Adog64/ECE-Synthesizer-Spring-2023/README.md

# ECE-Synthesizer-Spring-2023

Our project consists of a synthesizer that plays notes from C4 to B5 using buttons. The MSP430 provides square, triangle, and sawtooth waves. The audio will be comprised of a combination of these waves, which can be altered. The volume will be adjustable.
