Adog64/ECE-Synthesizer-Spring-2023/MSP-EXP430FR2355_Hardware_Design_Files/Readme.txt

MSP-EXP430FR2355 Hardware Design Files v1.00.00
Texas Instruments, Inc.

********************************************************************************
Welcome to the MSP-EXP430FR2355 LaunchPad!
********************************************************************************

In this package, you will find hardware design files that can help you quickly
get started on developing your own project.

Available in the 'Hardware' folder are the complete board schematic and layout,
bill of material and Gerber files. This board was designed using Altium.

You can also find various web links in the 'Documentation' folder pointing to
the Tool Page, Quick Start Guide, and User's Guide.

For more resources, be sure to visit www.ti.com/tool/msp-exp430fr2355

********************************************************************************
Revision History
********************************************************************************
Ver 1.00.00 - May 15, 2018
- Initial Release of Rev1.0 PCB

********************************************************************************
Project File Listing
********************************************************************************
|--Documentation                      : Folder containing links to more resources
|--Hardware                           : Folder containing hardware design files,
                                        bill of material and gerber files
|--Readme.txt                         : This file
