Adog64/ECE-Synthesizer-Spring-2023/Write Ups/ProjectOverview.tex

\documentclass{IEEEtran}

\title{Homebrew Synthesizer}
\author{Aidan Sharpe \& Elise Heim}

\begin{document}
\maketitle

\begin{abstract}
    This homebrew synthesizer combines the worlds of embedded systems and electronics. Using an array of buttons as inputs, a monophonic---one note at a time--- output frequency can be selected. All fundamental waveforms, whether that be square, triangle, saw tooth, or sine, are generated simultaneously and at the same frequency by the onboard microcontroller. Fundamental waveforms are outputted on separate channels, so each can be treated as a component of a final mixed waveform. Using a digital to analog converter, each output can be scaled using a rheostat. Using a voltage summer, the fundamental waveforms are combined to create a unique sound which can be output over an onboard headphone jack or a Bluetooth signal.
\end{abstract}

\section{Block Diagraming}

\end{document}
