Adog64/ECE-Synthesizer-Spring-2023/MSP430FR2355-Package-Outline.png

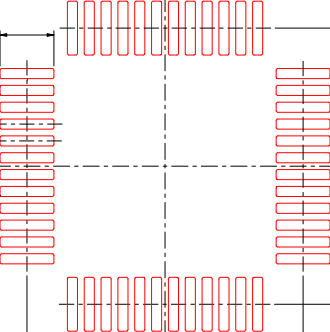
MSP430FR2355-Package-Outline.png
