Adog64/ECE-Synthesizer-Spring-2023/NINA-W156-Mechanical.png

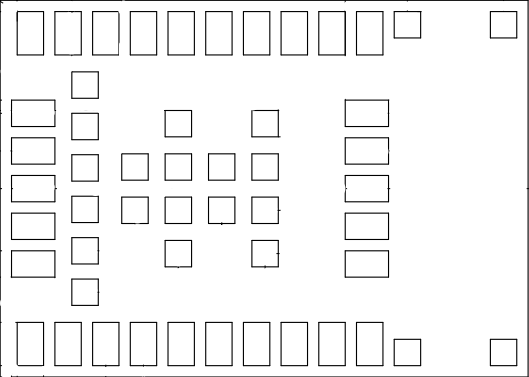
NINA-W156-Mechanical.png
