Adog64/ECE-Synthesizer-Spring-2023/MSP-EXP430FR2355_Hardware_Design_Files/Hardware/MCU036A(001)_BOM.xls

Filename: | #VALUE!
Variant: | 001
Generated: | 3/2/2018 10:15:17 AM
 |  | MSP-EXP430FR2355
Designator | Quantity | Value | Description | PackageReference | PartNumber | Manufacturer | Alternate PartNumber | Alternate Manufacturer
!PCB | 1 |  | Printed Circuit Board |  | MCU036 | Any | - | -
C1, C112 | 2 | 1000pF | CAP, CERM, 1000 pF, 50 V, +/- 10%, X7R, 0402 | 0402 | GRM155R71H102KA01D | MuRata
C2, C3 | 2 | 12pF | CAP, CERM, 12 pF, 25 V, +/- 5%, C0G/NP0, 0402 | 0402 | GRM1555C1E120JA01D | MuRata
C4 | 1 | 0.1uF | CAP, CERM, 0.1 µF, 50 V, +/- 20%, X5R, 0402 | 0402 | GRM155R61H104ME14D | MuRata
C5 | 1 | 10uF | CAP, CERM, 10 µF, 6.3 V, +/- 20%, X5R, 0603 | 0603 | GRM188R60J106ME84 | MuRata
C6 | 1 | 1pF | CAP, CERM, 1 pF, 50 V, +/- 10%, C0G/NP0, 0402 | 0402 | GRM1555C1H1R0BA01D | MuRata
C101 | 1 | 0.47uF | CAP, CERM, 0.47 µF, 16 V, +/- 10%, X5R, 0402 | 0402 | GRM155R61C474KE01 | MuRata
C102, C107 | 2 | 0.22uF | CAP, CERM, 0.22 µF, 16 V, +/- 10%, X5R, 0603 | 0603 | GRM188R61C224KA88D | MuRata
C103, C105, C113, C114, C118, C120, C121, C124, C125 | 9 | 0.1uF | CAP, CERM, 0.1 µF, 10 V, +/- 10%, X5R, 0402 | 0402 | GRM155R61A104KA01D | MuRata
C104 | 1 | 10uF | CAP, TA, 10 µF, 10 V, +/- 20%, 3.4 ohm, SMD | 3216-18 | 293D106X0010A2TE3 | Vishay-Sprague
C106, C109 | 2 | 4.7uF | CAP, TA, 4.7 µF, 10 V, +/- 10%, 5 ohm, SMD | 3216-18 | 293D475X9010A2TE3 | Vishay-Sprague
C108 | 1 | 1uF | CAP, CERM, 1 µF, 10 V, +/- 10%, X5R, 0603 | 0603 | GRM185R61A105KE36D | MuRata
C110, C111 | 2 | 10pF | CAP, CERM, 10 pF, 50 V, +/- 5%, C0G/NP0, 0402 | 0402 | GRM1555C1H100JA01D | MuRata
C115, C116, C122, C123 | 4 | 33pF | CAP, CERM, 33 pF, 50 V, +/- 5%, C0G/NP0, 0402 | 0402 | GRM1555C1H330JA01D | MuRata
C117, C119 | 2 | 4.7uF | CAP, CERM, 4.7 µF, 16 V, +/- 10%, X5R, 0603 | 0603 | GRM188R61C475KAAJ | MuRata
C126 | 1 | 0.22uF | CAP, CERM, 0.22 µF, 10 V, +/- 10%, X5R, 0402 | 0402 | GRM155R61A224KE19D | MuRata
D1 | 1 | 820nm | High Speed PIN Photodiode, SMD | 3.2x1.5mm | SFH 2701 | OSRAM
D101, D102 | 2 | 40V | Diode, Schottky, 40 V, 0.12 A, AEC-Q101, SOT-323 | SOT-323 | BAS40-05W,115 | NXP Semiconductor
H1, H2 | 2 |  | Spacer Support, Nylon 66 | Spacer Nylon Support | MAE-10 | Kang Yang
IC101 | 1 |  | Single Output LDO, 200 mA, Fixed 3.3 V Output, 2 to 5.5 V Input, with Low IQ, 6-pin WSON (DSE), -40 to 125 degC, Green (RoHS & no Sb/Br) | DSE0006A | TLV70033DSET | Texas Instruments | Equivalent | Texas Instruments
IC102 | 1 |  | ESD-Protection Array for High-Speed Data Interfaces, 4 Channels, -40 to +85 degC, 6-pin SON (DRY), Green (RoHS & no Sb/Br) | DRY0006A | TPD4E004DRYR | Texas Instruments | Equivalent | Texas Instruments
IC103 | 1 |  | 0.75-Ohm DUAL SPST ANALOG SWITCH WITH 1.8-V COMPATIBLE INPUT LOGIC, RSE0008A (UQFN-8) | RSE0008A | TS5A21366RSER | Texas Instruments |  | Texas Instruments
J1/J3, J2/J4 | 2 |  | Receptacle, 2.54mm, 10x2, Tin, TH | 10x2 Receptacle | SSQ-110-03-T-D | Samtec | CRD-081413-A-G | Major League Electronics
J5, J6 | 2 |  | Header, 100mil, 3x1, Tin, TH | Header, 3 PIN, 100mil, Tin | PEC03SAAN | Sullins Connector Solutions
J7, J8, J9, J10, J11 | 5 |  | Header, 100mil, 2x1, Gold, TH | 2x1 Header | TSW-102-07-G-S | Samtec
J12 | 1 |  | Header(shrouded), 2mm, 4x1, Tin, R/A, TH | Header(shrouded), 2mm, 4x1, R/A, TH | 110990037 | SEEED
J101 | 1 |  | Header, 100mil, 7x2, Tin, TH | Header, 7x2, 100mil, Tin | PEC07DAAN | Sullins Connector Solutions
J102 | 1 |  | Receptacle, USB 2.0, Micro B, 5 Position, R/A, SMT | Receptacle, USB 2.0, Micro B, 5 Pos, 0.65mm Pitch, R/A, SMT | 1051640001 | Molex
L101 | 1 | 2.2uH | Inductor, Wirewound, Ceramic, 2.2 µH, 0.89 A, 0.13 ohm, SMD | 2.5x1.8x1.8mm | CBC2518T2R2M | Taiyo Yuden
L102, L103 | 2 | 1000 ohm | Ferrite Bead, 1000 ohm @ 100 MHz, 0.6 A, 0603 | 0603 | BLM18HE102SN1D | MuRata
LED1, LED101 | 2 | Red | LED, Red, SMD | Red LED, 1.6x0.8x0.8mm | LTST-C190CKT | Lite-On
LED2, LED102 | 2 | Green | LED, Green, SMD | 1.6x0.8x0.8mm | LTST-C190GKT | Lite-On
MSP1 | 1 |  | Mixed-Signal Microcontroller, PT0048A (LQFP-48) | PT0048A | MSP430FR2355TPT | Texas Instruments | XMS430FR2355TPT | Texas Instruments
MSP101 | 1 |  | 25 MHz Mixed Signal Microcontroller with 128 KB Flash, 8192 B SRAM and 47 GPIOs, -40 to 85 degC, 64-pin QFN (RGC), Green (RoHS & no Sb/Br) | RGC0064B | MSP430F5528IRGCT | Texas Instruments | Equivalent | Texas Instruments
MSP102 | 1 |  | 16 MHz Mixed Signal Microcontroller with 8 KB Flash, 256 B SRAM and 16 GPIOs, 16-pin QFN (RSA), Green (RoHS & no Sb/Br) | RSA0016B | MSP430G2452IRSA16R | Texas Instruments | Equivalent | Texas Instruments
Q1 | 1 |  | Crystal, 32.768 KHz, 12.5 pF, SMD | SMD, 2-Leads, Body 3.2x1.5mm | ECS-.327-12.5-34B-TR | ECS Inc.
Q101 | 1 |  | Resonator, 4MHz, 39pF SMD | 4.5x1.2x2 mm | CSTCR4M00G15L99-R0 | MuRata
R1 | 1 | 47.0k | RES, 47.0 k, 1%, 0.0625 W, 0402 | 0402 | RC0402FR-0747KL | Yageo America
R2 | 1 | 470 | RES, 470, 1%, 0.063 W, 0402 | 0402 | RC0402FR-07470RL | Yageo America
R3 | 1 | 2.37Meg | RES, 2.37 M, 1%, 0.1 W, 0603 | 0603 | CRCW06032M37FKEA | Vishay-Dale
R6 | 1 | 392 | RES, 392, 1%, 0.063 W, 0402 | 0402 | CRCW0402392RFKED | Vishay-Dale
R101, R120 | 2 | 470 | RES, 470, 5%, 0.063 W, 0402 | 0402 | CRCW0402470RJNED | Vishay-Dale
R102 | 1 | 390 | RES, 390, 5%, 0.063 W, 0402 | 0402 | CRCW0402390RJNED | Vishay-Dale
R103, R104 | 2 | 27 | RES, 27, 5%, 0.063 W, 0402 | 0402 | CRCW040227R0JNED | Vishay-Dale
R105 | 1 | 1.40k | RES, 1.40 k, 1%, 0.063 W, 0402 | 0402 | CRCW04021K40FKED | Vishay-Dale
R106 | 1 | 1.0Meg | RES, 1.0 M, 5%, 0.063 W, 0402 | 0402 | CRCW04021M00JNED | Vishay-Dale
R107, R108 | 2 | 4.70k | RES, 4.70 k, 1%, 0.063 W, 0402 | 0402 | CRG0402F4K7 | TE Connectivity
R109 | 1 | 47k | RES, 47 k, 5%, 0.063 W, 0402 | 0402 | CRCW040247K0JNED | Vishay-Dale
R112, R113, R114, R115, R121, R122 | 6 | 221k | RES, 221 k, 1%, 0.063 W, 0402 | 0402 | CRCW0402221KFKED | Vishay-Dale
R116, R117 | 2 | 4.7k | RES, 4.7 k, 5%, 0.063 W, 0402 | 0402 | CRCW04024K70JNED | Vishay-Dale
R118 | 1 | 820 | RES, 820, 1%, 0.063 W, 0402 | 0402 | RC0402FR-07820RL | Yageo America
R119 | 1 | 0 | RES, 0, 5%, 0.063 W, 0402 | 0402 | CRCW04020000Z0ED | Vishay-Dale
R123 | 1 | 33k | RES, 33 k, 5%, 0.063 W, 0402 | 0402 | CRCW040233K0JNED | Vishay-Dale
R124 | 1 | 240k | RES, 240 k, 1%, 0.063 W, 0402 | 0402 | CRCW0402240KFKED | Vishay-Dale
R125 | 1 | 150k | RES, 150 k, 1%, 0.063 W, 0402 | 0402 | CRCW0402150KFKED | Vishay-Dale
R126 | 1 | 2.20k | RES, 2.20 k, 1%, 0.063 W, 0402 | 0402 | CRCW04022K20FKED | Vishay-Dale
R127 | 1 | 3.30k | RES, 3.30 k, 1%, 0.1 W, AEC-Q200 Grade 0, 0402 | 0402 | ERJ-2RKF3301X | Panasonic
R128 | 1 | 6.81k | RES, 6.81 k, 1%, 0.063 W, 0402 | 0402 | CRCW04026K81FKED | Vishay-Dale
R129, R130 | 2 | 10.0 | RES, 10.0, 1%, 0.063 W, 0402 | 0402 | CRCW040210R0FKED | Vishay-Dale
S1, S2, S3 | 3 |  | Switch, SPST, 0.05 A, 12 VDC, SMD | 7.8x3.5mm | 1188E-1K2-V-TR | Diptronics
SH-J7, SH-J8, SH-J9, SH-J10, SH-J11, SH-J101-1, SH-J101-2, SH-J101-3, SH-J101-4, SH-J101-5, SH-J101-6, SH-J101-7 | 12 | 1x2 | Shunt, 100mil, Gold plated, Black | Shunt | 969102-0000-DA | 3M | SNT-100-BK-G | Samtec
T101 | 1 | -20V | MOSFET, P-CH, -20 V, -0.82 A, SOT-323 | SOT-323 | DMG1013UW-7 | Diodes Inc. |  | None
T102 | 1 | 45 V | Transistor, NPN, 45 V, 0.1 A, SOT-323 | SOT-323 | BC850CW,115 | NXP Semiconductor
USB1 | 1 |  | Cable, USB-A to micro USB-B, 0.3 m |  | AK67421-0.3 | Assman WSW
C127 | 0 | 100pF | CAP, CERM, 100 pF, 50 V, +/- 5%, C0G/NP0, 0402 | 0402 | GRM1555C1H101JA01D | MuRata
FID1, FID2, FID3 | 0 |  | Fiducial mark. There is nothing to buy or mount. | N/A | N/A | N/A
TP101, TP102, TP103, TP104, TP105, TP106, TP107, TP108, TP109 | 0 |  | Test Point, Miniature, Black, TH | Black Miniature Testpoint | 5001 | Keystone
 |  | Notes:
 |  | Unless otherwise noted in the Alternate PartNumber and/or Alternate Manufacturer columns, all parts may be substituted with equivalents.
