Adog64/ECE-Synthesizer-Spring-2023/EnclosureModels/synthesizer.step

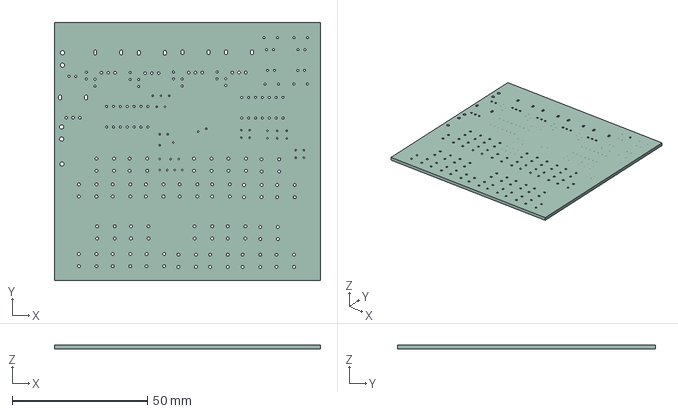
[picture p10: CAD file, 2023-04-26]
EnclosureModels/synthesizer.step
98.2 x 95.2 x 1.60 mm
