Adog64/ECE-Synthesizer-Spring-2023/MSP-EXP430FR2355_Hardware_Design_Files/Hardware/MSP-EXP430FR2355_Schematic.PDF

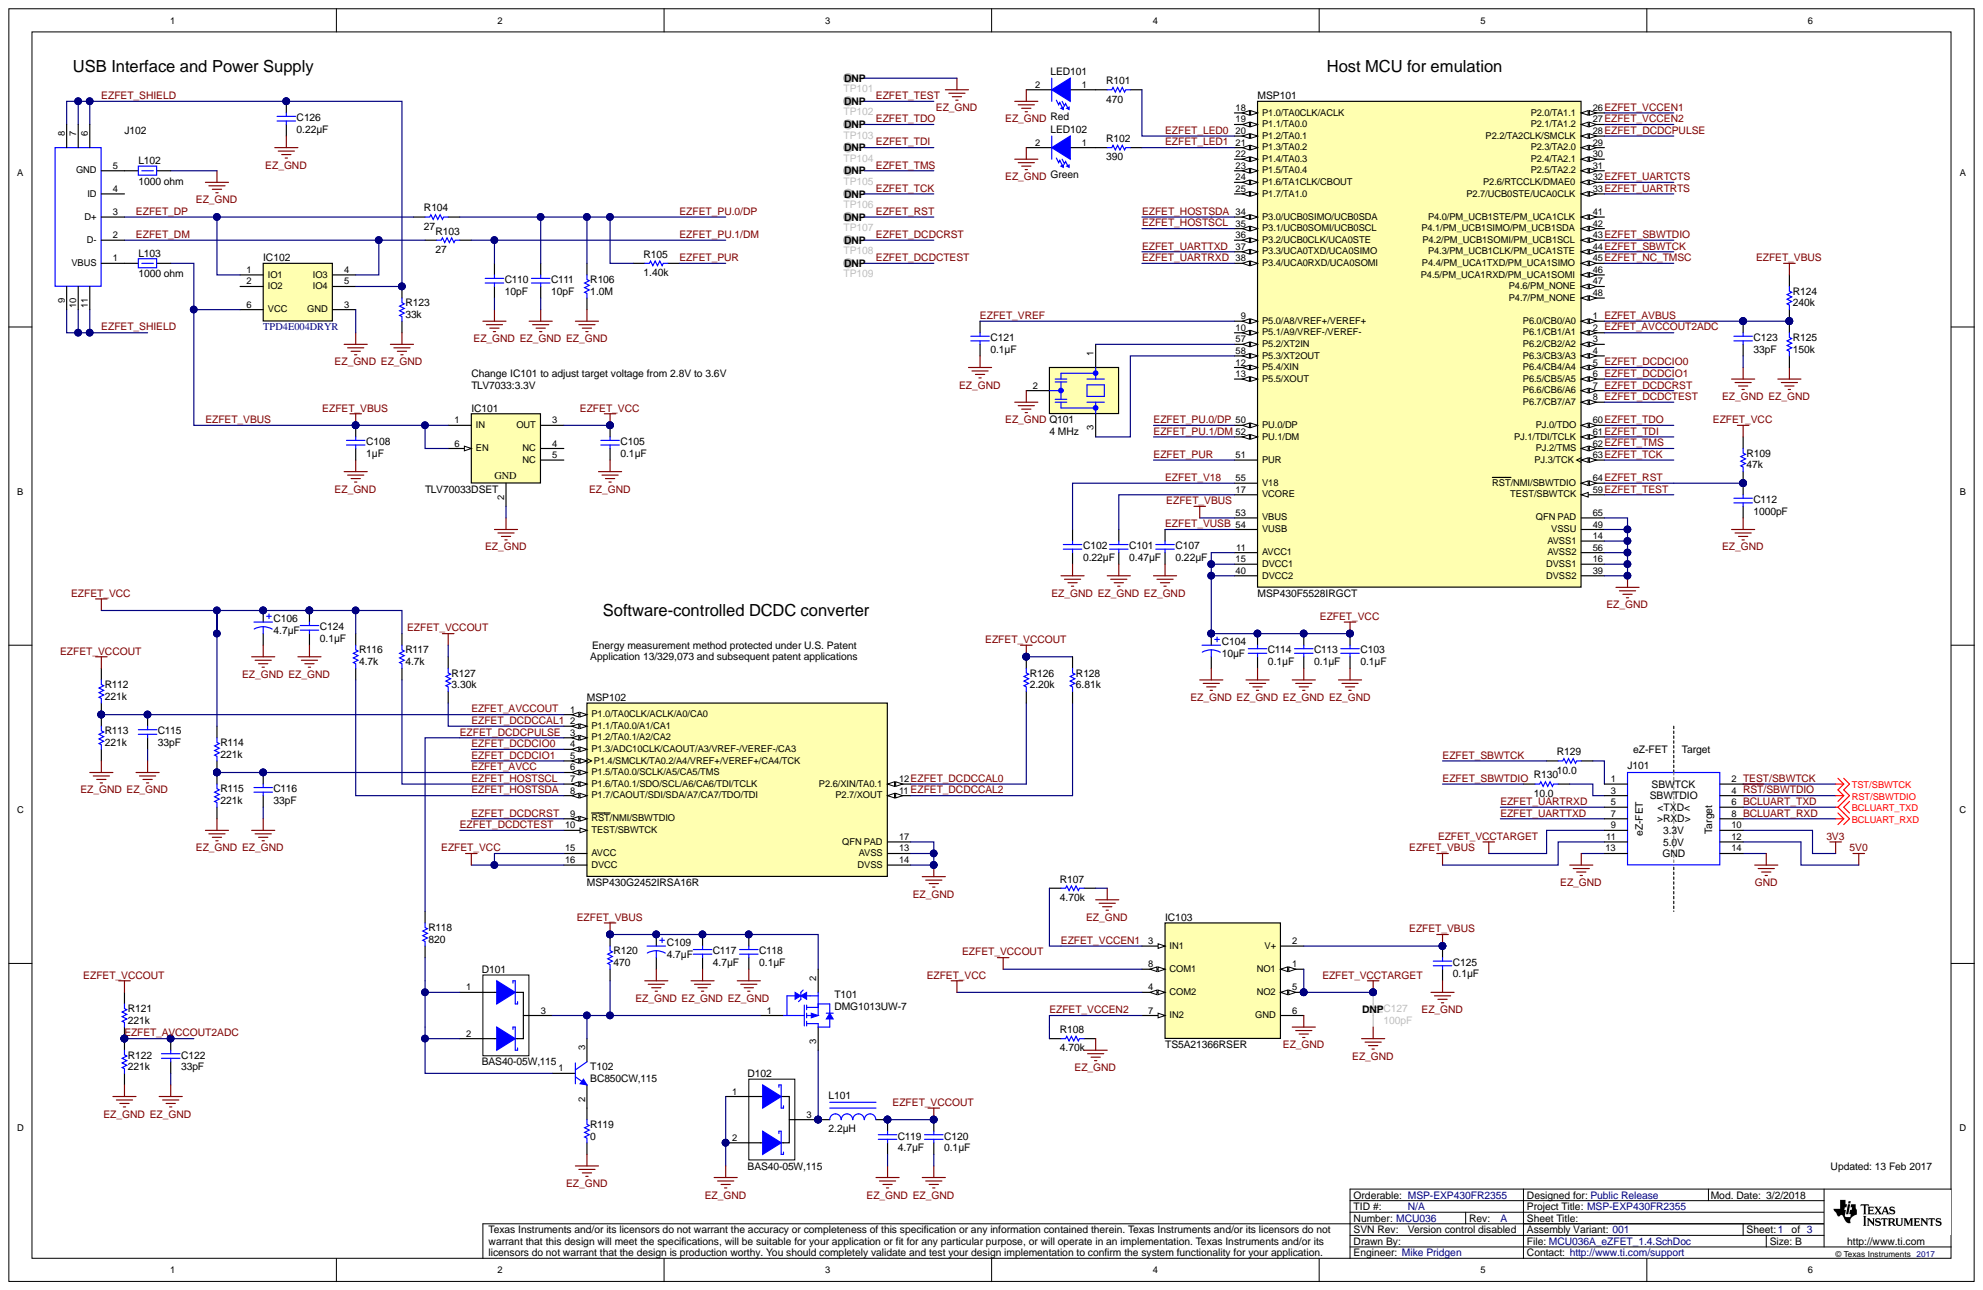
[picture p11: page 1]

USB Interface and Power Supply

Host MCU for emulation

EZFET_SHIELD

P5.1/A9/VREF-/VEREF- 10 | EZFET_AVCCOUT2ADC

Change IC101 to adjust target voltage from 2.8V to 3.6V
TLV7033:3.3V

EZFET_PU.0/DP EZFET_PU.1/DM | P5.4/XIN 12

P5.5/XOUT 13 | EZFET_DCDCIO1

VCORE 17 | EZFET_TEST

EZFET_VBUS EZFET_VUSB | VBUS 53

Software-controlled DCDC converter

Energy measurement method protected under U.S. Patent
Application 13/329,073 and subsequent patent applications

EZFET_HOSTSDA | P1.7/CAOUT/SDI/SDA/A7/CA7/TDO/TDI 8 | EZFET_DCDCCAL2

EZFET_DCDCRST | | RST/NMI/SBWTDIO 9

Orderable: MSP-EXP430FR2355 | Designed for: Public Release | Mod. Date: | http://www.ti.com
TID #: N/A | Project Title: MSP-EXP430FR2355
Number: MCU036 | Rev: A | Sheet Title:
SVN Rev: Version control disabled | Assembly Variant: 001 | Sheet: of
Drawn By: | File: MCU036A_eZFET_1.4.SchDoc | Size: B

Texas Instruments and/or its licensors do not warrant the accuracy or completeness of this specification or any information contained therein. Texas Instruments and/or its licensors do not
warrant that this design will meet the specifications, will be suitable for your application or fit for any particular purpose, or will operate in an implementation. Texas Instruments and/or its
licensors do not warrant that the design is production worthy. You should completely validate and test your design implementation to confirm the system functionality for your application.

Contact: http://www.ti.com/support © Texas Instruments 2017

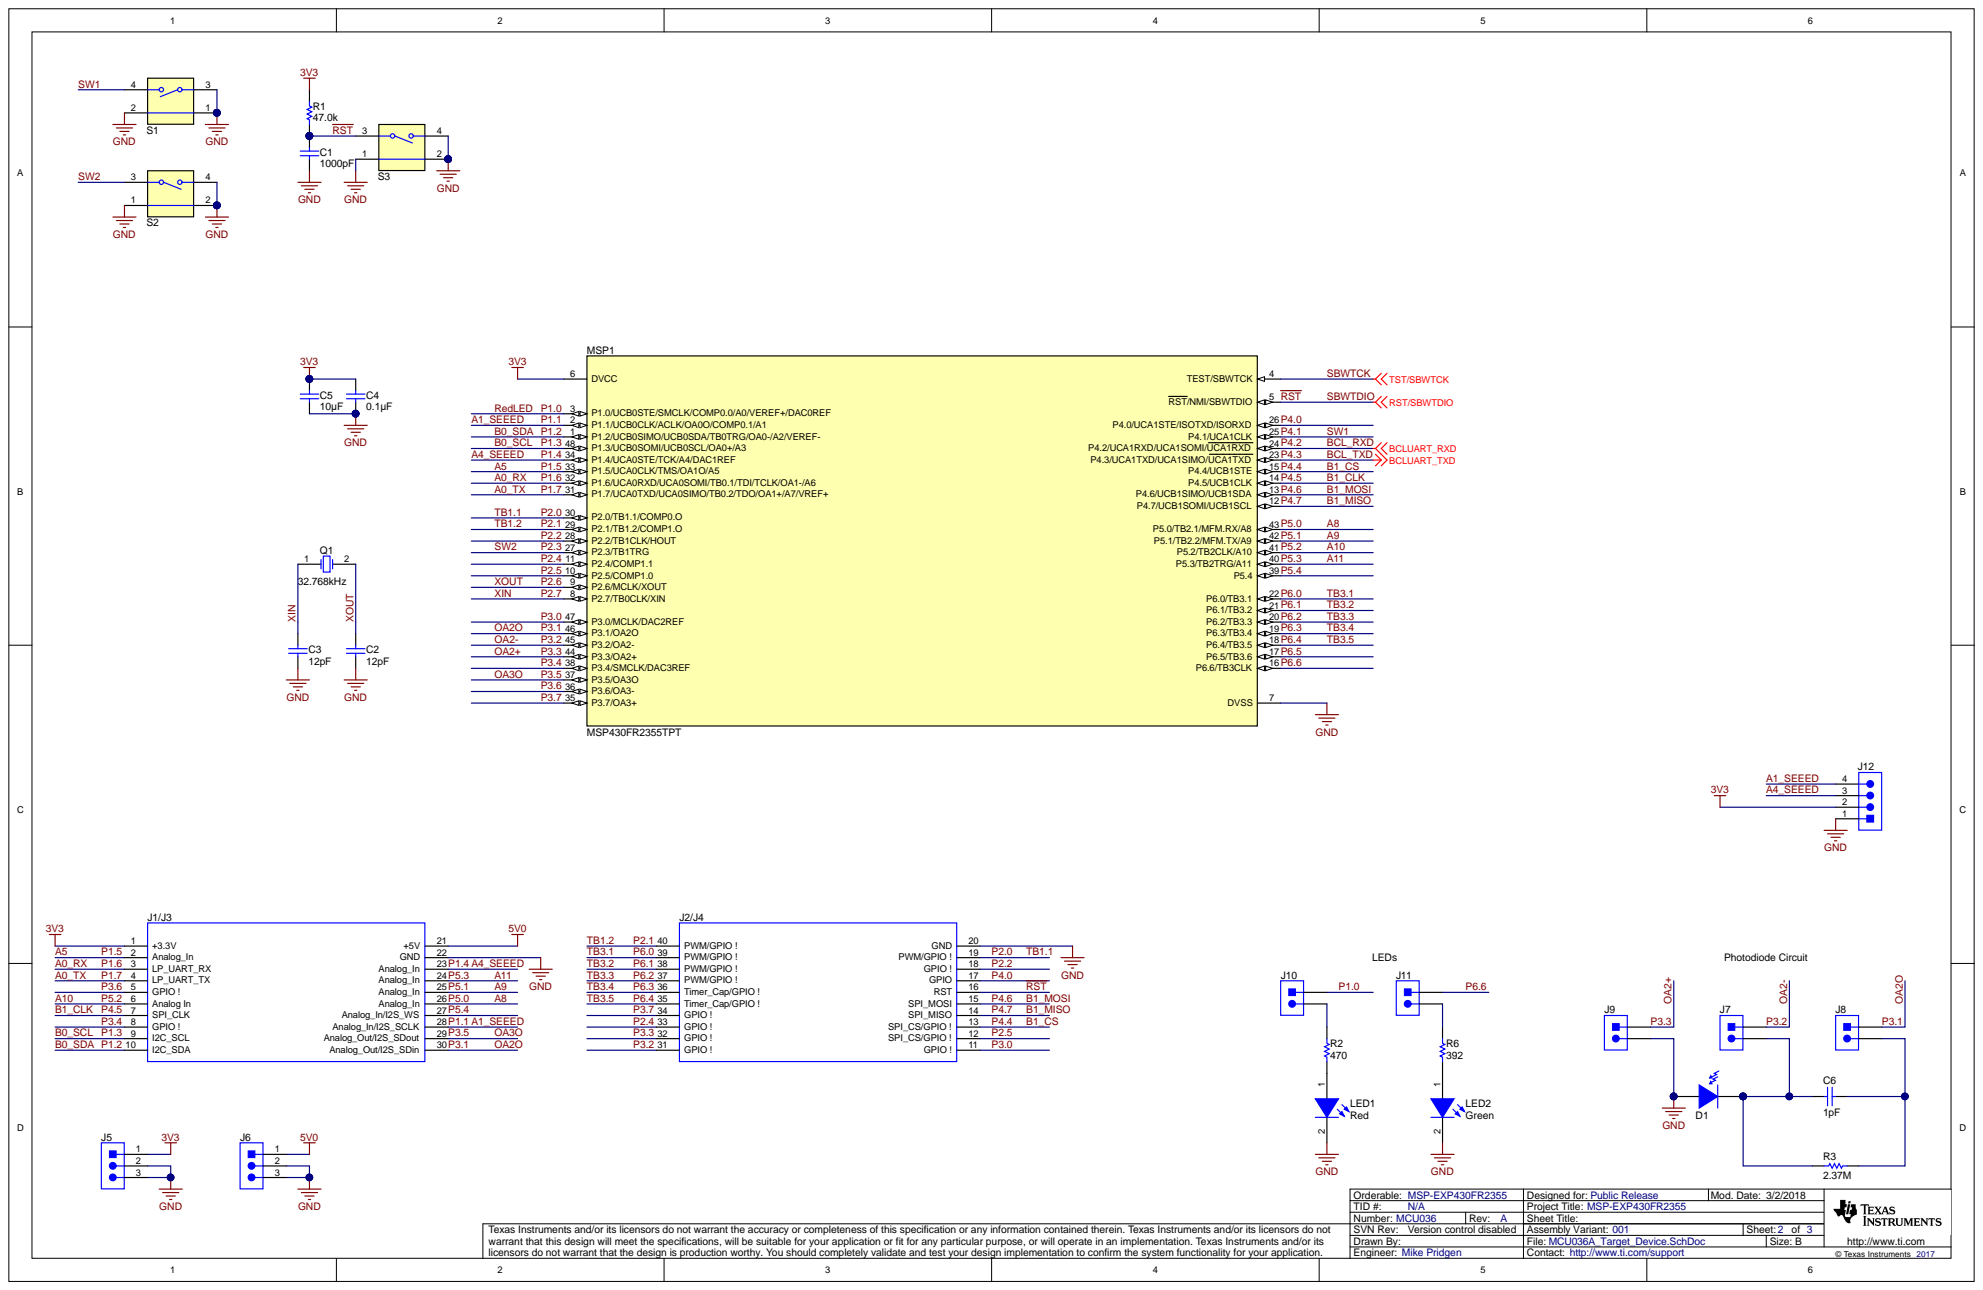
[picture p12: page 2]

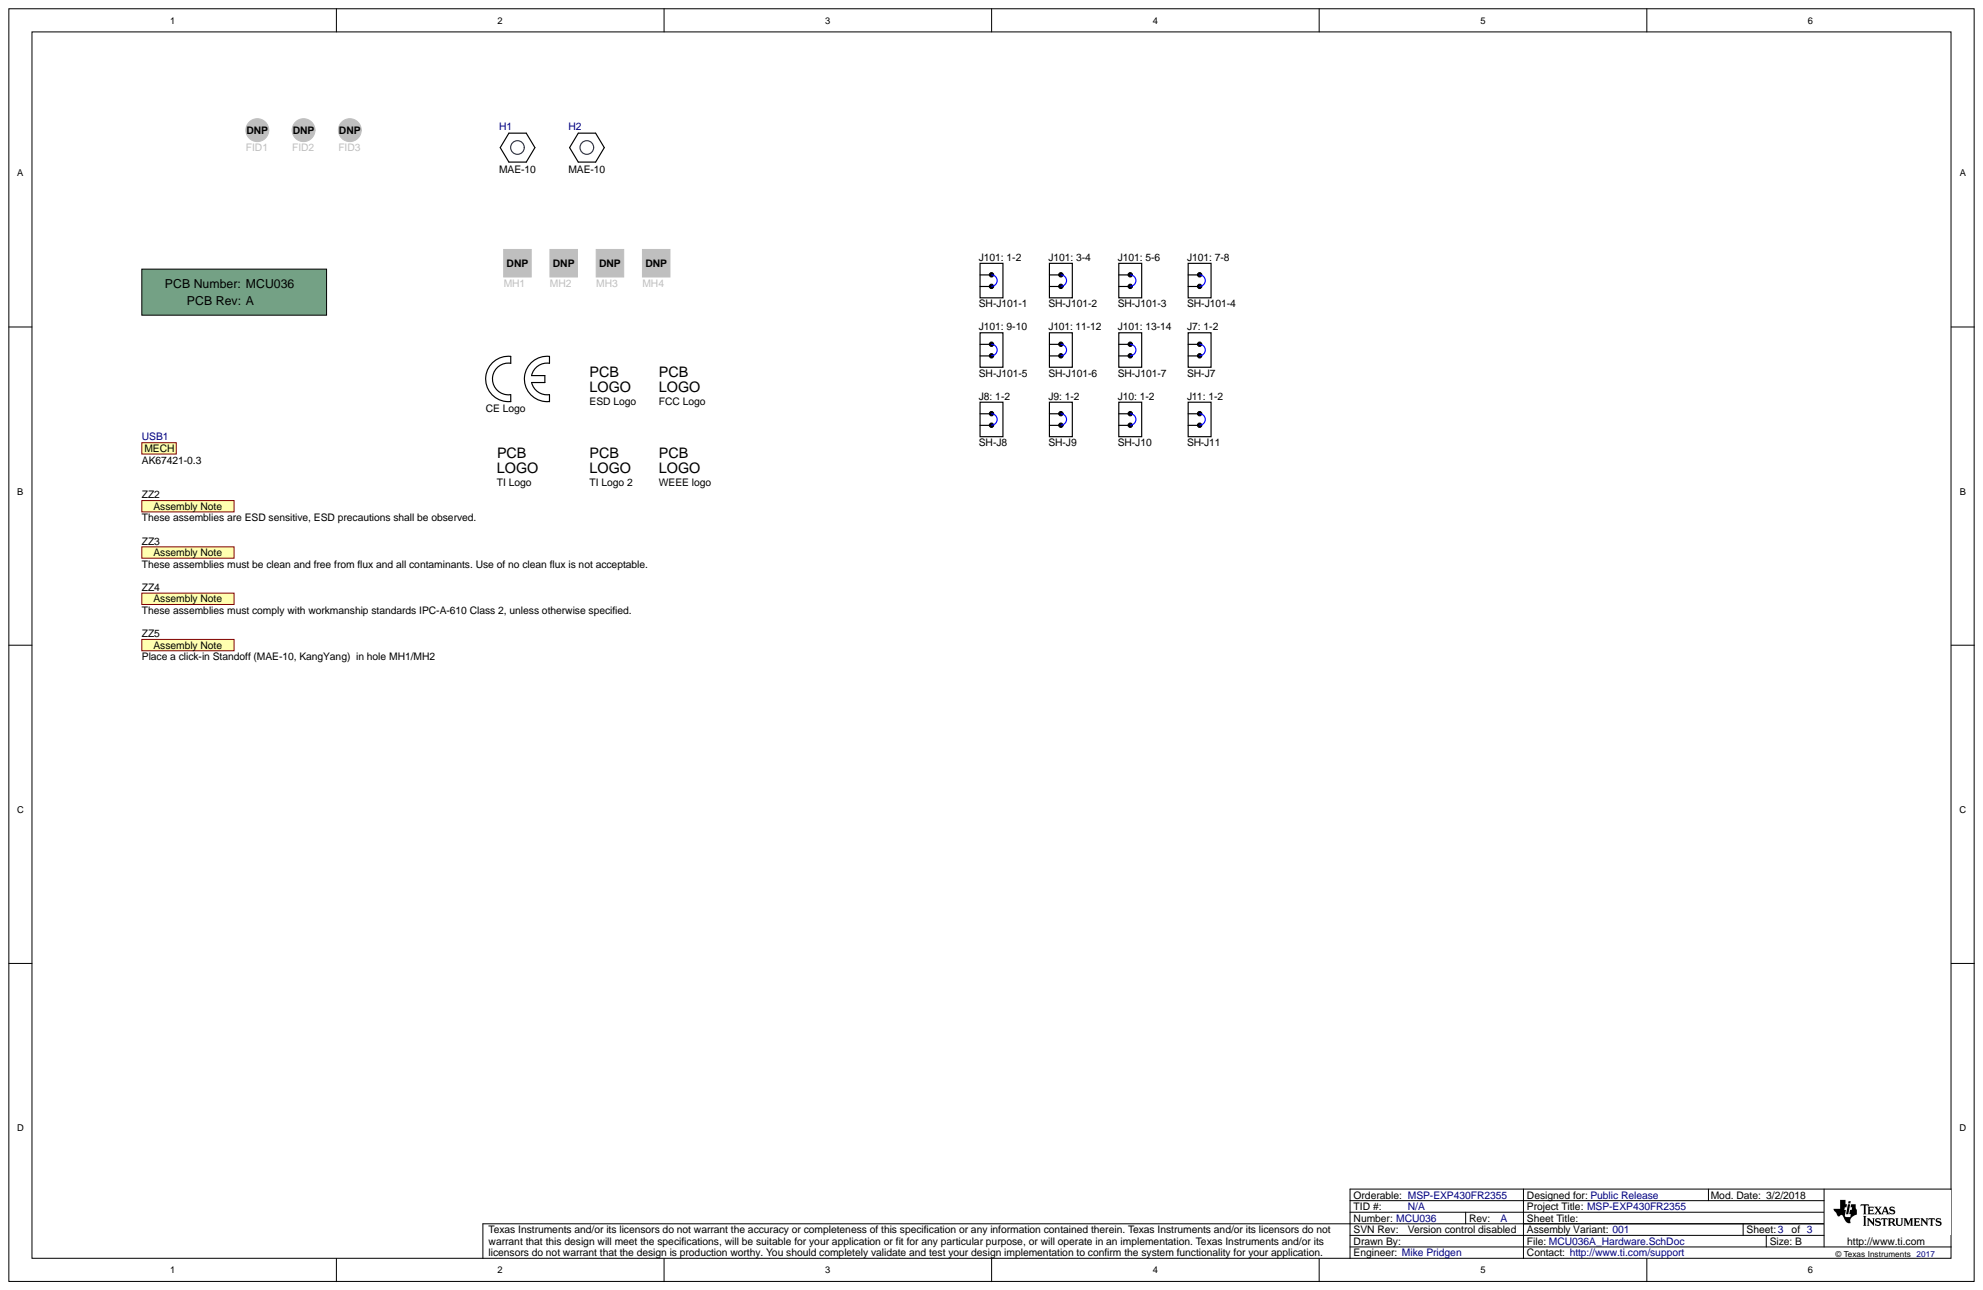
[picture p13: page 3]

Assembly Note
These assemblies are ESD sensitive, ESD precautions shall be observed.

These assemblies must be clean and free from flux and all contaminants. Use of no clean flux is not acceptable.

These assemblies must comply with workmanship standards IPC-A-610 Class 2, unless otherwise specified.

Place a click-in Standoff (MAE-10, KangYang) in hole MH1/MH2
