Adog64/ECE-Synthesizer-Spring-2023/Simulations/PulseWidthDAC.asc

C1: cap; 1n
C2: cap; 1n
R1: res; 8.2k
R2: res; 8.2k
R3: res; 5k
R4: res; 5k
R5: res; 10k
R6: res; 10k
R7: res; 10k
R8: res; 10k
R9: res; 10k
U1: LT1366
U2: LT1366
U3: LT1366
V1: voltage; PWL file=saw_outs.pwl
V2: voltage; PWL file=tri_outs.pwl
V3: voltage; 1.65
V4: voltage; 3.3
Named nets: 0, Saw, Tri, 3v3, VirtGND, Saw_iso, Tri_iso
.tran 250U
