Adog64/ECE-Synthesizer-Spring-2023/(list of files, drawings)

Other design files:
MSP-EXP430FR2355_Hardware_Design_Files/Hardware/Cad Source Files/MCU036A_eZFET_1.4.SchDoc
MSP-EXP430FR2355_Hardware_Design_Files/Hardware/Cad Source Files/MCU036A_Hardware.SchDoc
MSP-EXP430FR2355_Hardware_Design_Files/Hardware/Cad Source Files/MCU036A_MSP-EXP430FR2355.PrjPcb
MSP-EXP430FR2355_Hardware_Design_Files/Hardware/Cad Source Files/MCU036A_Target_Device.SchDoc
