Adog64/ECE-Synthesizer-Spring-2023/SythesizerKiCAD/synthesizer.kicad_pcb

## KiCad design SythesizerKiCAD/synthesizer.kicad_pcb (2023-04-13)

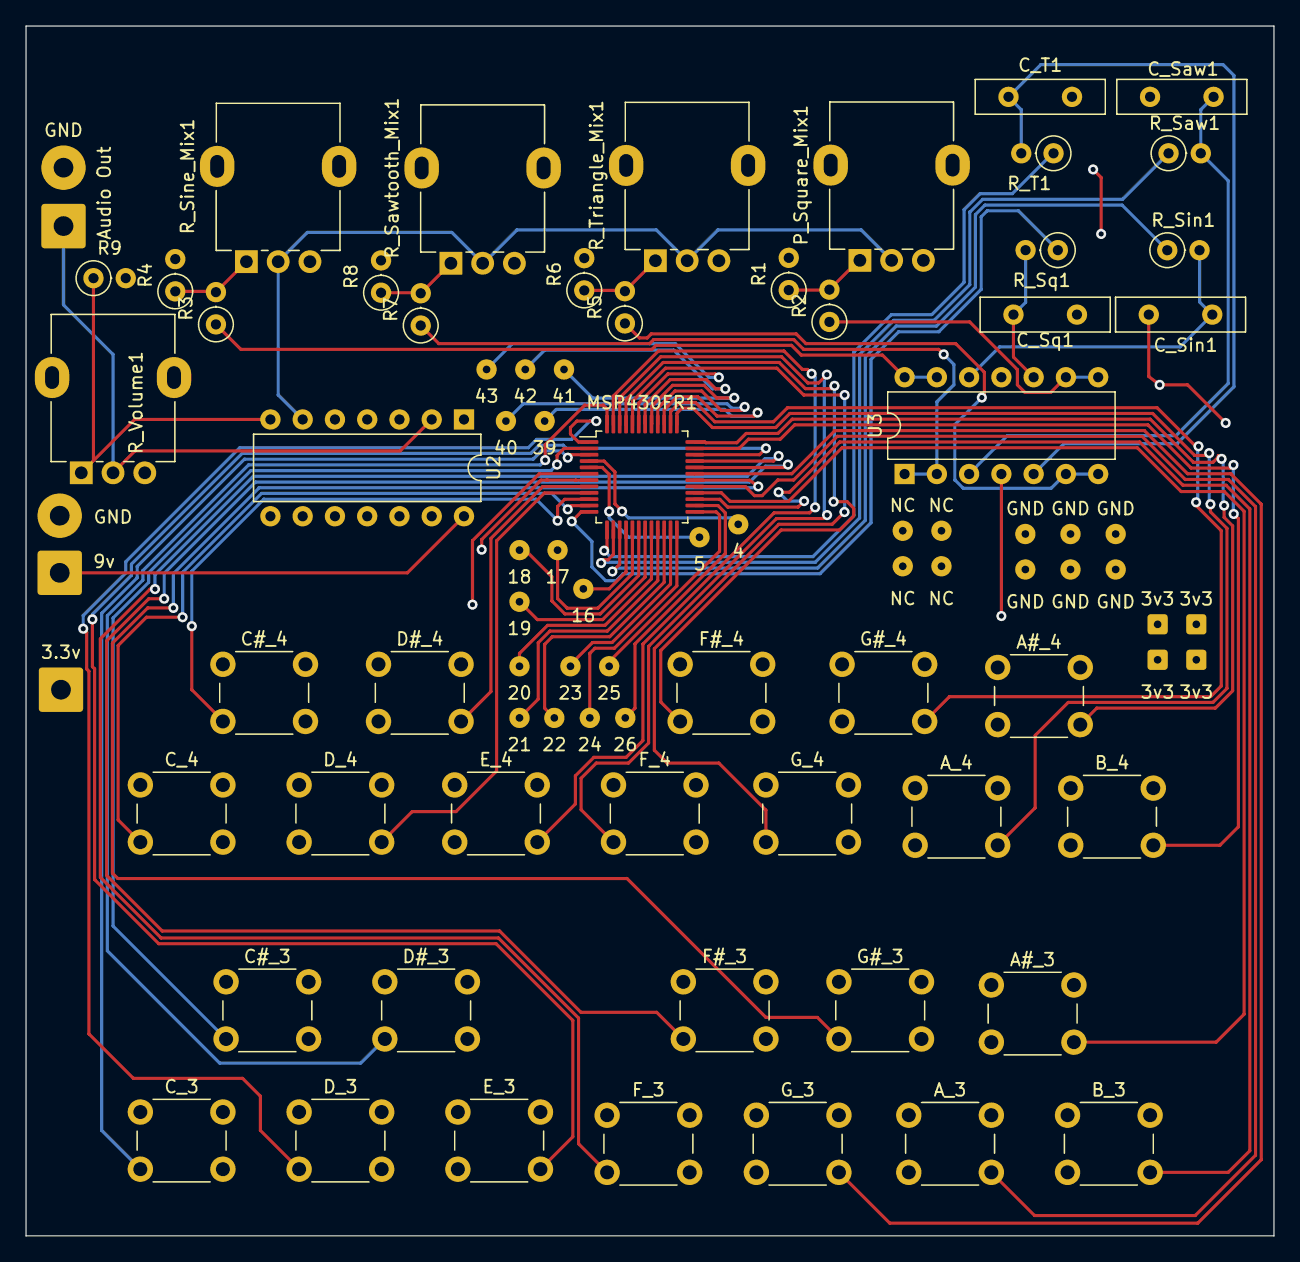
[picture p14: board synthesizer.kicad_pcb from above]

Board: 2 copper layers, 98.2 x 95.2 mm, 86 parts (0 on the bottom side), 48 nets.

Parts:
3.3v, 9v: SolderWire-0.75sqmm_1x01_D1.25mm_OD3.5mm
3v3, 3v3#2, 3v3#3, 3v3#4, 4, 5, 16, 17, 18, 19, 20, 21, 22, 23, 24, 25, 26, 39, 40, 41, 42, 43: SolderWire-0.1sqmm_1x01_D0.4mm_OD1mm
A#_3, A#_4: SW_Push; SW_PUSH_6mm_H5mm
A_3, A_4: SW_Push; SW_PUSH_6mm_H5mm
Audio Out: SolderWire-0.75sqmm_1x01_D1.25mm_OD3.5mm
B_3, B_4: SW_Push; SW_PUSH_6mm_H5mm
C#_3, C#_4: SW_Push; SW_PUSH_6mm_H5mm
C_3, C_4: SW_Push; SW_PUSH_6mm_H5mm
C_Saw1: 1nF; C_Disc_D10.0mm_W2.5mm_P5.00mm
C_Sin1: 1nF; C_Disc_D10.0mm_W2.5mm_P5.00mm
C_Sq1: 1nF; C_Disc_D10.0mm_W2.5mm_P5.00mm
C_T1: 1nF; C_Disc_D10.0mm_W2.5mm_P5.00mm
D#_3, D#_4: SW_Push; SW_PUSH_6mm_H5mm
D_3, D_4: SW_Push; SW_PUSH_6mm_H5mm
E_3, E_4: SW_Push; SW_PUSH_6mm_H5mm
F#_3, F#_4: SW_Push; SW_PUSH_6mm_H5mm
F_3, F_4: SW_Push; SW_PUSH_6mm_H5mm
G#_3, G#_4: SW_Push; SW_PUSH_6mm_H5mm
GND: SolderWire-0.1sqmm_1x01_D0.4mm_OD1mm
GND#2, GND#3, GND#4, GND#6, GND#8: SolderWire-0.1sqmm_1x01_D0.4mm_OD1mm
GND#5, GND#7: SolderWire-0.75sqmm_1x01_D1.25mm_OD3.5mm
G_3, G_4: SW_Push; SW_PUSH_6mm_H5mm
MSP430FR1: LQFP-48_7x7mm_P0.5mm
NC: SolderWire-0.1sqmm_1x01_D0.4mm_OD1mm
NC#2, NC#3, NC#4: SolderWire-0.1sqmm_1x01_D0.4mm_OD1mm
P_Square_Mix1: R_Potentiometer_US; Potentiometer_Alpha_RD901F-40-00D_Single_Vertical
R1, R4, R6, R8, R9: 100k; R_Axial_DIN0207_L6.3mm_D2.5mm_P2.54mm_Vertical
R2, R3, R5, R7: 300k; R_Axial_DIN0207_L6.3mm_D2.5mm_P2.54mm_Vertical
R_Saw1: 8.2k; R_Axial_DIN0207_L6.3mm_D2.5mm_P2.54mm_Vertical
R_Sawtooth_Mix1: R_Potentiometer_US; Potentiometer_Alpha_RD901F-40-00D_Single_Vertical
R_Sin1: 8.2k; R_Axial_DIN0207_L6.3mm_D2.5mm_P2.54mm_Vertical
R_Sine_Mix1: R_Potentiometer_US; Potentiometer_Alpha_RD901F-40-00D_Single_Vertical
R_Sq1: 8.2k; R_Axial_DIN0207_L6.3mm_D2.5mm_P2.54mm_Vertical
R_T1: 8.2k; R_Axial_DIN0207_L6.3mm_D2.5mm_P2.54mm_Vertical
R_Triangle_Mix1: R_Potentiometer_US; Potentiometer_Alpha_RD901F-40-00D_Single_Vertical
R_Volume1: R_Potentiometer_US; Potentiometer_Alpha_RD901F-40-00D_Single_Vertical
U2: LM1877; DIP-14_W7.62mm
U3: LMC6484; DIP-14_W7.62mm

Connections:
/3v3: 3.3v.1, 3v3.1, 3v3#2.1, 3v3#3.1, 3v3#4.1, A#_3.1, A#_4.1, A_3.1, A_4.1, B_3.1, B_4.1, C#_3.1, C#_4.1, C_3.1, C_4.1, D#_3.1, D#_4.1, D_3.1, D_4.1, E_3.1, E_4.1, F#_3.1, F#_4.1, F_3.1, F_4.1, G#_3.1, G#_4.1, G_3.1, G_4.1, MSP430FR1.6 (DVCC), U3.4 (V+)
/9v: 9v.1, U2.14 (V+)
/Audio_Out: Audio Out.1, GND#5.1, R_Volume1.2, U2.2
/GND: C_Saw1.2, C_Sin1.2, C_Sq1.2, C_T1.2, GND.1, GND#2.1, GND#3.1, GND#4.1, GND#6.1, GND#7.1, GND#8.1, MSP430FR1.7 (DVSS), P_Square_Mix1.3, R1.2, R4.2, R6.2, R8.2, R9.2, R_Sawtooth_Mix1.3, R_Sine_Mix1.3, R_Triangle_Mix1.3, U2.3 (GND), U2.4 (GND), U2.5 (GND), U2.10 (GND), U2.11 (GND), U2.12 (GND), U3.11 (V-)
/Mixed: P_Square_Mix1.2, R_Sawtooth_Mix1.2, R_Sine_Mix1.2, R_Triangle_Mix1.2, U2.6 (+)
/P1.0: C_3.2, MSP430FR1.3 (P1.0/UCB0STE/SMCLK/COMP0.0/A0/Veref+)
/P1.1: C#_3.2, MSP430FR1.2 (P1.1/UCB0CLK/ACLK/OA0O/COMP0.1/A1)
/P1.2: D_3.2, MSP430FR1.1 (P1.2/UCB0SIMO/UCB0SDA/TB0TRG/OA0-/A2/Ve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)
/P1.3: D#_3.2, MSP430FR1.48 (1.3/UCB0SOMI/UCB0SCL/A3)
/P1.4: E_3.2, MSP430FR1.34 (P1.4/UCA0STE/TCK/A4)
/P1.5: F_3.2, MSP430FR1.33 (P1.5/UCA0CLK/TMS/A5)
/P1.6: F#_3.2, MSP430FR1.32 (P1.6/UCA0RXD/UCA0SOMI/TB0.1/TDI/TCLK/A6)
/P1.7: G_3.2, MSP430FR1.31 (P1.7/UCA0TXD/UCA0SIMO/TB0.2/TDO/A7/VREF+)
/P2.0: G#_3.2, MSP430FR1.30 (P2.0/TB1.1/COMP0.O)
/P2.1: A_3.2, MSP430FR1.29 (P2.1/TB1.2/COMP1.O)
/P2.2: A#_3.2, MSP430FR1.28 (P2.2/TB1CLK)
/P2.3: B_3.2, MSP430FR1.27 (P2.3/TB1TRG)
/P2.4: C_4.2, MSP430FR1.11 (P2.4/COMP1.1)
/P2.5: C#_4.2, MSP430FR1.10 (P2.5/COMP1.0)
/P2.6: D_4.2, MSP430FR1.9 (P2.6/MCLK/XOUT)
/P2.7: D#_4.2, MSP430FR1.8 (P2.7/TB0CLK/XIN)
/P3.0: E_4.2, MSP430FR1.47 (P3.0/MCLK)
/P3.1: F_4.2, MSP430FR1.46 (P3.1)
/P3.2: F#_4.2, MSP430FR1.45 (P3.2)
/P3.3: G_4.2, MSP430FR1.44 (P3.3)
/P3.4: G#_4.2, MSP430FR1.38 (P3.4/SMCLK)
/P3.5: A_4.2, MSP430FR1.37 (P3.5)
/P3.6: A#_4.2, MSP430FR1.36 (P3.6)
/P3.7: B_4.2, MSP430FR1.35 (P3.7)
/Sawtooth_Analog: C_Saw1.1, R_Saw1.2, U3.3 (+)
/Sawtooth_Divided: R7.2, R8.1, R_Sawtooth_Mix1.1
/Sawtooth_Isolated: R7.1, U3.1, U3.2 (-)
/Sawtooth_PWM: MSP430FR1.14 (P4.5/UCB1CLK), R_Saw1.1
/Sine_Analog: C_Sin1.1, R_Sin1.2, U3.12 (+)
/Sine_Divided: R3.2, R4.1, R_Sine_Mix1.1
/Sine_Isolated: R3.1, U3.13 (-), U3.14
/Sine_PWM: MSP430FR1.15 (P4.4/UCB1STE), R_Sin1.1
/Square_Analog: C_Sq1.1, R_Sq1.2, U3.10 (+)
/Square_Divided: P_Square_Mix1.1, R1.1, R2.2
/Square_Isolated: R2.1, U3.8, U3.9 (-)
/Square_PWM: MSP430FR1.12 (P4.7/UCB1SOMI/UCB1SCL), R_Sq1.1
/Triangle_Analog: C_T1.1, R_T1.2, U3.5 (+)
/Triangle_Divided: R5.2, R6.1, R_Triangle_Mix1.1
/Triangle_Isolated: R5.1, U3.6 (-), U3.7
/Triangle_PWM: MSP430FR1.13 (P4.6/UCB1SIMO/UCB1SDA), R_T1.1
/UART_MSP_RX: 24.1, MSP430FR1.24 (P4.2/UCA1RXD/UCA1SOMI/UCA1RXD)
/UART_MSP_TX: 23.1, MSP430FR1.23 (P4.3/UCA1TXD/UCA1SIMO/UCA1TXD)
unnamed: R9.1, R_Volume1.1, U2.7 (-)
