Adog64/ECE-Synthesizer-Spring-2023/TriangleWaveTesting/freq_period.h

// ====== FREQUENCIES =====
#define f_C3    131
#define f_Cs3   139
#define f_D3    147
#define f_Ds3   156
#define f_E3    165
#define f_F3    175
#define f_Fs3   185
#define f_G3    196
#define f_Gs3   208
#define f_A3    220
#define f_As3   233
#define f_B3    247
#define f_C4    262
#define f_Cs4   277
#define f_D4    294
#define f_Ds4   311
#define f_E4    330
#define f_F4    349
#define f_Fs4   379
#define f_G4    382
#define f_Gs4   415
#define f_A4    449
#define f_As4   466
#define f_B4    494

// === 62500 / FREQUENCIES ===
#define f_C3_62500  478
#define f_Cs3_62500 451
#define f_D3_62500  426
#define f_Ds3_62500 402
#define f_E3_62500  379
#define f_F3_62500  358
#define f_Fs3_62500 338
#define f_G3_62500  319
#define f_Gs3_62500 301
#define f_A3_62500  284
#define f_As3_62500 268
#define f_B3_62500  253
#define f_C4_62500  239
#define f_Cs4_62500 225
#define f_D4_62500  213
#define f_Ds4_62500 201
#define f_E4_62500  190
#define f_F4_62500  179
#define f_Fs4_62500 169
#define f_G4_62500  159
#define f_Gs4_62500 150
#define f_A4_62500  142
#define f_As4_62500 134
#define f_B4_62500  127

// === 31250 / FREQUENCIES ===
#define f_C3_31250  239
#define f_Cs3_31250 225
#define f_D3_31250  213
#define f_Ds3_31250 201
#define f_E3_31250  190
#define f_F3_31250  179
#define f_Fs3_31250 169
#define f_G3_31250  159
#define f_Gs3_31250 150
#define f_A3_31250  142
#define f_As3_31250 134
#define f_B3_31250  127
#define f_C4_31250  119
#define f_Cs4_31250 113
#define f_D4_31250  106
#define f_Ds4_31250 100
#define f_E4_31250  95
#define f_F4_31250  89
#define f_Fs4_31250 84
#define f_G4_31250  80
#define f_Gs4_31250 75
#define f_A4_31250  71
#define f_As4_31250 67
#define f_B4_31250  64

// === 15625 / FREQUENCIES ===
#define f_C3_15625  119
#define f_Cs3_15625 113
#define f_D3_15625  106
#define f_Ds3_15625 100
#define f_E3_15625  95
#define f_F3_15625  89
#define f_Fs3_15625 84
#define f_G3_15625  80
#define f_Gs3_15625 75
#define f_A3_15625  71
#define f_As3_15625 67
#define f_B3_15625  63
#define f_C4_15625  60
#define f_Cs4_15625 56
#define f_D4_15625  53
#define f_Ds4_15625 50
#define f_E4_15625  47
#define f_F4_15625  45
#define f_Fs4_15625 42
#define f_G4_15625  40
#define f_Gs4_15625 38
#define f_A4_15625  36
#define f_As4_15625 34
#define f_B4_15625  32
