Adog64/ECE-Synthesizer-Spring-2023/(commit log)

2023-04-04 Mostly done with PCB.
    [SythesizerKiCAD.kicad_pcb, SythesizerKiCAD.kicad_sch, synthesizer.kicad_pcb, synthesizer.kicad_sch]
2023-04-04 Lowpass filters and isolators
    [synthesizer.kicad_pcb, synthesizer.kicad_sch]
2023-04-05 Volume, audio out, power in
    [synthesizer.kicad_pcb, synthesizer.kicad_sch]
2023-04-05 Fixed ground issue
    [synthesizer.kicad_pcb]
2023-04-06 Removed NINA, breakouts for MSP, extra pads
    [synthesizer.kicad_pcb]
2023-04-06 Generated Gerber Files and Drill Files
    [synthesizer-B_Cu.gbr, synthesizer-B_Mask.gbr, synthesizer-B_Paste.gbr, synthesizer-B_Silkscreen.gbr, synthesizer-Edge_Cuts.gbr, synthesizer-F_Cu.gbr, synthesizer-F_Mask.gbr, synthesizer-F_Paste.gbr]
2023-04-13 Frequencies and timer periods
2023-04-26 Some MCU code updates
    [synthesizer.step]
2023-05-01 Python PWM generator
2023-05-01 PWM Simulations
2023-05-01 First iter PWM signal outputs
2023-05-03 MSP test code & filter sim
